ktemkin-archive/papilio-drv8833-wing/papilio_drv8833_wing.pdf

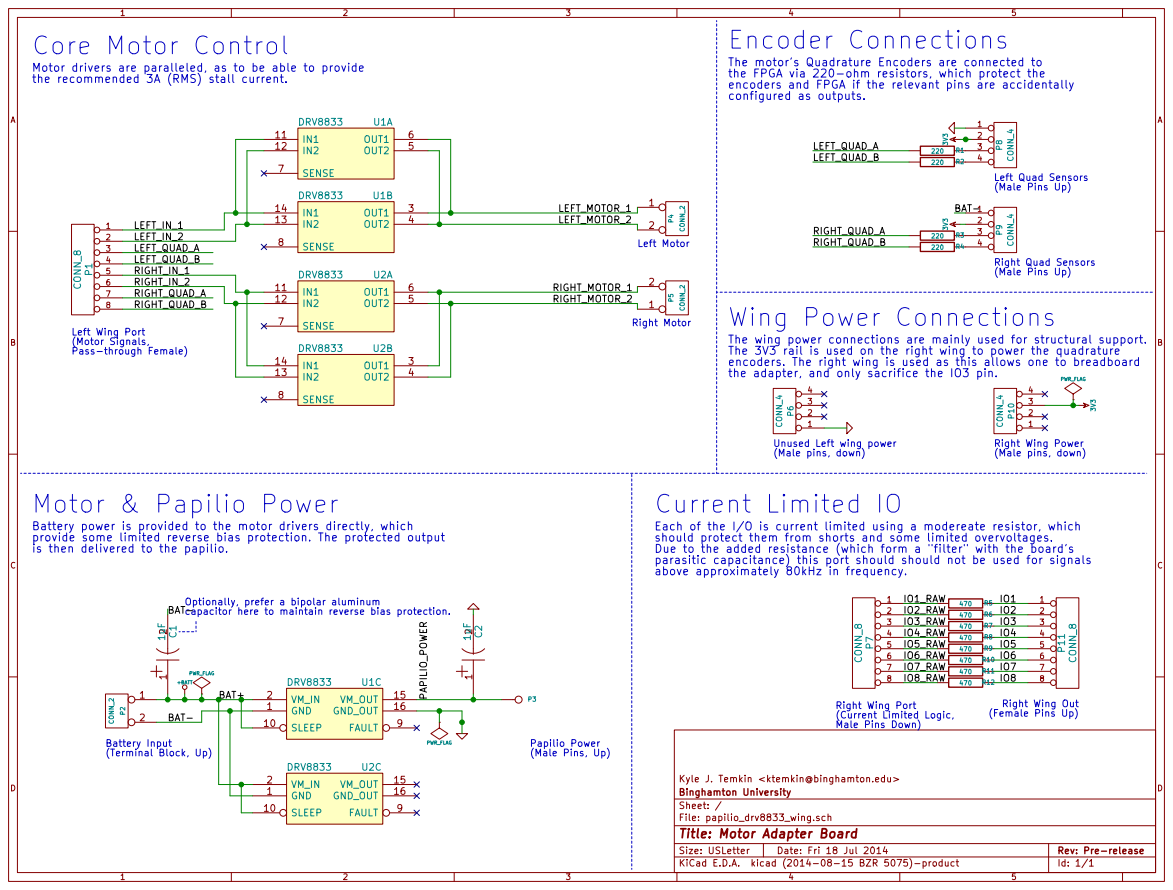
[picture p1: page 1]

The motor's Quadrature Encoders are connected to
the FPGA via 220-ohm resistors, which protect the
encoders and FPGA if the relevant pins are accidentally
configured as outputs.

Motor drivers are paralleled, as to be able to provide
the recommended 3A (RMS) stall current.

The wing power connections are mainly used for structural support.
The 3V3 rail is used on the right wing to power the quadrature
encoders. The right wing is used as this allows one to breadboard
the adapter, and only sacrifice the IO3 pin.

(Male pins, down) 1
Unused Left wing power

Battery power is provided to the motor drivers directly, which
provide some limited reverse bias protection. The protected output
is then delivered to the papilio.

Each of the I/O is current limited using a modereate resistor, which
should protect them from shorts and some limited overvoltages.
Due to the added resistance (which form a "filter" with the board's
parasitic capacitance) this port should should not be used for signals

Kyle J. Temkin <ktemkin@binghamton.edu>
File: papilio_drv8833_wing.sch Sheet: / Binghamton University

Id: 1/1 Title: Motor Adapter Board
