ktemkin-archive/papilio-drv8833-wing/papilio_drv8833_wing.kicad_pcb

## KiCad design papilio_drv8833_wing.kicad_pcb (2015-10-08)

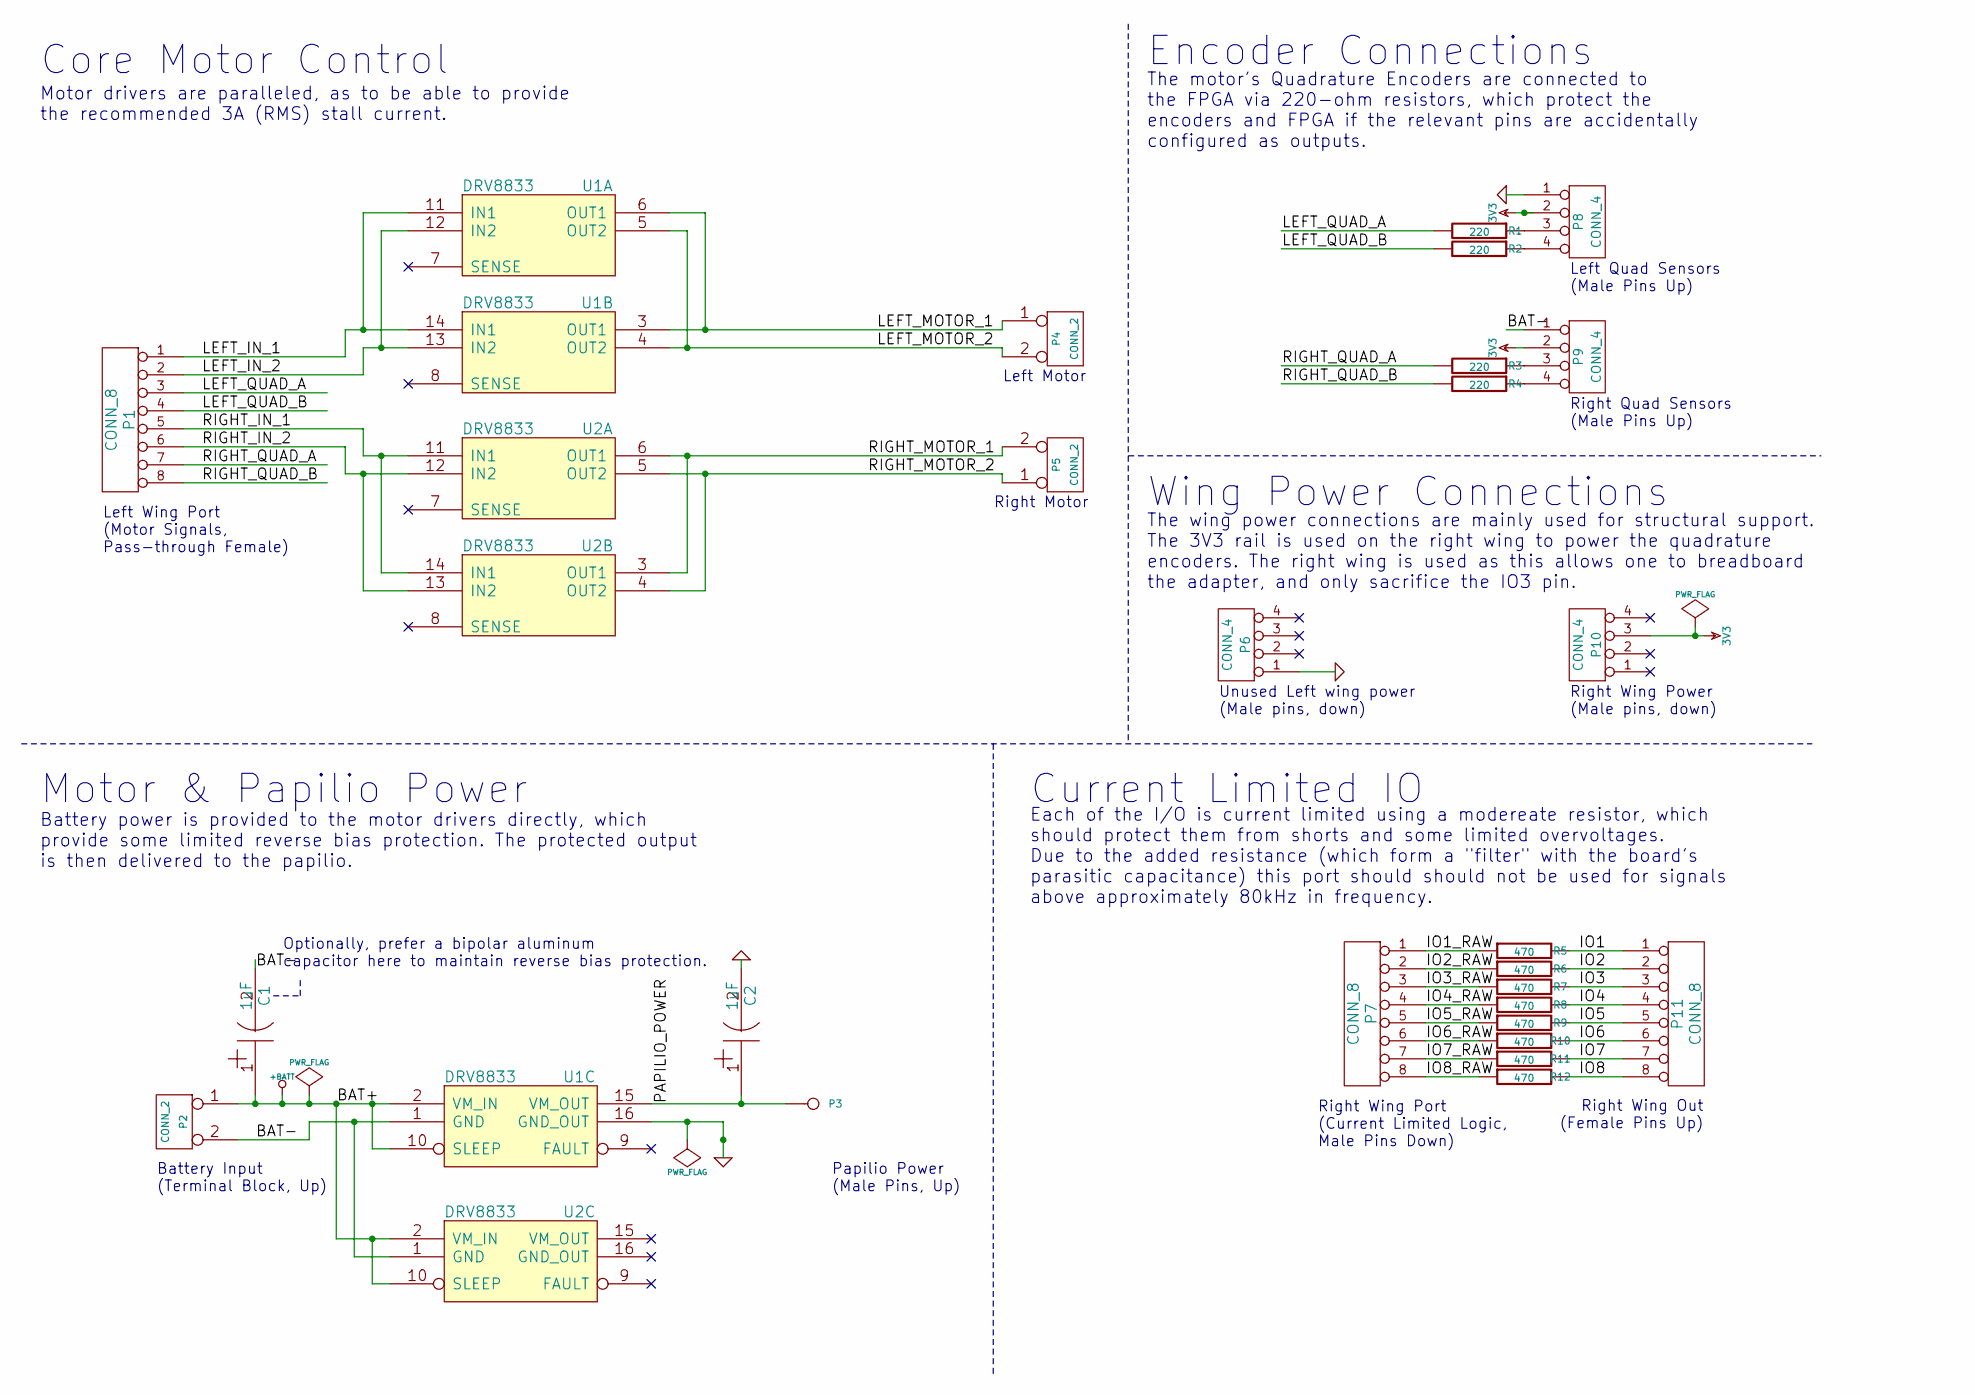
[picture p2: schematic papilio_drv8833_wing.sch, Motor Adapter Board]

Parts:
C1, C2: 1uF; Capacitor5x11RM2.5
P1, P7, P11: CONN_8; SIL-8
P2: CONN_2; terminal-block-D021B01LF
P3: CONN_1; SIL-1
P4, P5: CONN_2; rover5-motor
P6, P8, P9, P10: CONN_4; SIL-4
R1, R2, R3, R4: 220; Resistor_Horizontal_RM10mm
R5, R6, R7, R8, R9, R10, R11, R12: 470; Resistor_Horizontal_RM10mm
U1, U2: DRV8833; DRV8833-carrier

Connections:
3V3: P8.2, P9.2, P10.3
+BATT: C1.1, P2.1, U1.2 (VM_IN), U1.10 (SLEEP), U2.2 (VM_IN), U2.10 (SLEEP)
/BAT-: C1.2, P2.2 (PM), P9.1, U1.1 (GND), U2.1 (GND)
/IO1: P11.1, R5.2
/IO1_RAW: P7.1, R5.1
/IO2: P11.2, R6.2
/IO2_RAW: P7.2, R6.1
/IO3: P11.3, R7.2
/IO3_RAW: P7.3, R7.1
/IO4: P11.4, R8.2
/IO4_RAW: P7.4, R8.1
/IO5: P11.5, R9.2
/IO5_RAW: P7.5, R9.1
/IO6: P11.6, R10.2
/IO6_RAW: P7.6, R10.1
/IO7: P11.7, R11.2
/IO7_RAW: P7.7, R11.1
/IO8: P11.8, R12.2
/IO8_RAW: P7.8, R12.1
/LEFT_IN_1: P1.1, U1.11 (IN1), U1.14 (IN1)
/LEFT_IN_2: P1.2, U1.12 (IN2), U1.13 (IN2)
/LEFT_MOTOR_1: P4.1, U1.3 (OUT1), U1.6 (OUT1)
/LEFT_MOTOR_2: P4.2 (PM), U1.4 (OUT2), U1.5 (OUT2)
/LEFT_QUAD_A: P1.3, R1.2
/LEFT_QUAD_B: P1.4, R2.2
/PAPILIO_POWER: C2.1, P3.1, U1.15 (VM_OUT)
/RIGHT_IN_1: P1.5, U2.11 (IN1), U2.14 (IN1)
/RIGHT_IN_2: P1.6, U2.12 (IN2), U2.13 (IN2)
/RIGHT_MOTOR_1: P5.2 (PM), U2.3 (OUT1), U2.6 (OUT1)
/RIGHT_MOTOR_2: P5.1, U2.4 (OUT2), U2.5 (OUT2)
/RIGHT_QUAD_A: P1.7, R3.2
/RIGHT_QUAD_B: P1.8, R4.2
GND: C2.2, P6.1, P8.1, U1.16 (GND_OUT)
unnamed: P8.3, R1.1
unnamed: P8.4, R2.1
unnamed: P9.3, R3.1
unnamed: P9.4, R4.1

Notes on the sheet:
Right Wing Power (Male pins, down)
Left Wing Port (Motor Signals, Pass-through Female)
Left Quad Sensors (Male Pins Up)
Left Motor
Right Motor
Right Wing Port (Current Limited Logic, Male Pins Down)
Right Wing Out (Female Pins Up)
Right Quad Sensors (Male Pins Up)
Battery Input (Terminal Block, Up)
Papilio Power (Male Pins, Up)
Unused Left wing power (Male pins, down)
Core Motor Control
Motor drivers are paralleled, as to be able to provide the recommended 3A (RMS) stall current.
Motor & Papilio Power
Battery power is provided to the motor drivers directly, which provide some limited reverse bias protection. The protected output is then delivered to the papilio.
Encoder Connections
The motor's Quadrature Encoders are connected to the FPGA via 220-ohm resistors, which protect the encoders and FPGA if the relevant pins are accidentally configured as outputs.
Wing Power Connections
The wing power connections are mainly used for structural support. The 3V3 rail is used on the right wing to power the quadrature encoders. The right wing is used as this allows one to breadboard the adapter, and only sacrifice the IO3 pin.
Current Limited IO
Each of the I/O is current limited using a modereate resistor, which should protect them from shorts and some limited overvoltages. Due to the added resistance (which form a "filter" with the board's parasitic capacitance) this port should should not be used for signals above approximately 80kHz in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
Optionally, prefer a bipolar aluminum capacitor here to maintain reverse bias protection.

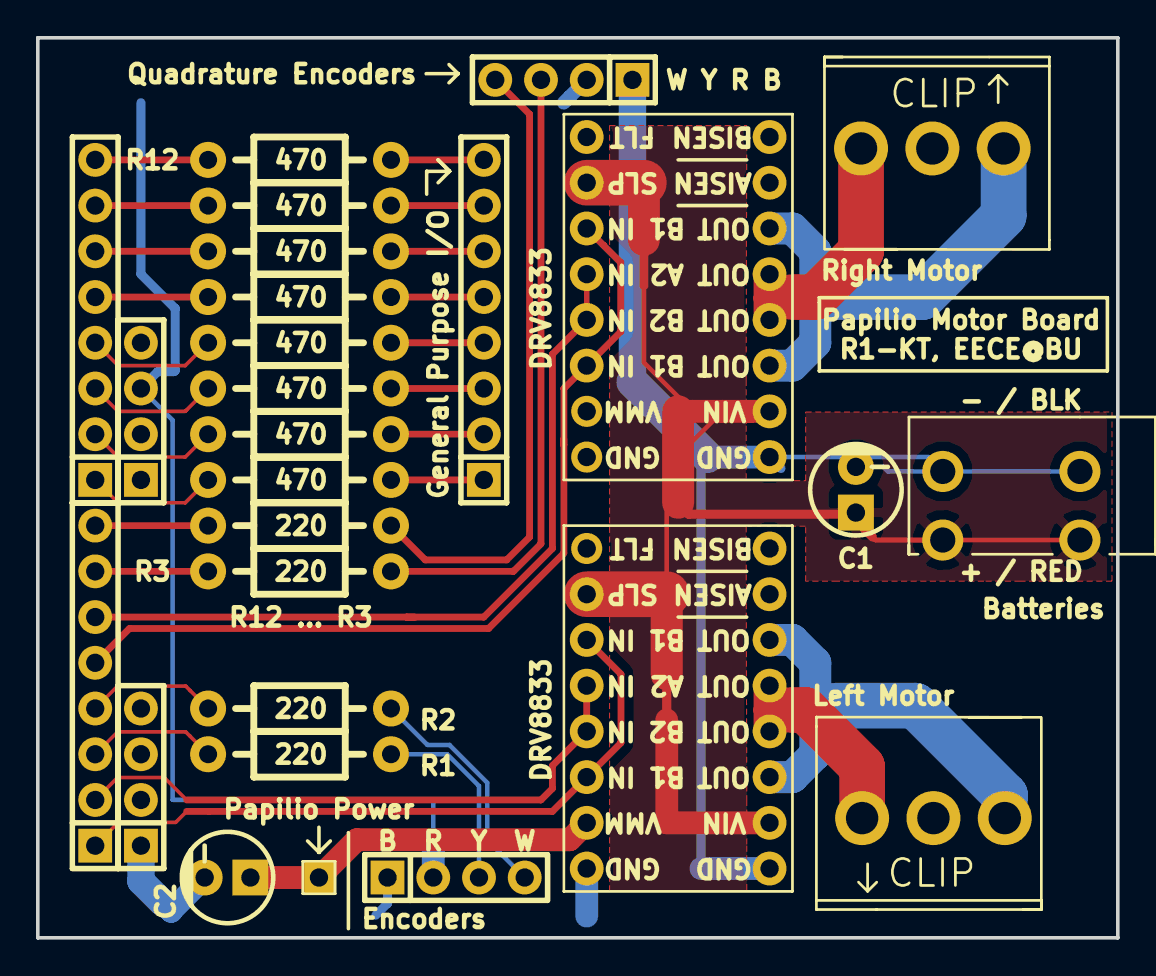
[picture p3: board papilio_drv8833_wing.kicad_pcb from above]

Board: 2 copper layers, 60.0 x 50.0 mm, 27 parts (0 on the bottom side), 37 nets.
