ktemkin-archive/papilio-drv8833-wing/TestVHDL/SwitchLED/toplevel_summary.html

toplevel Project Status (08/28/2014 - 21:10:19)
Project File: | SwitchLED.xise | Parser Errors: | No Errors
Module Name: | toplevel | Implementation State: | Synthesized (Failed)
Target Device: | xc3s250e-5cp132 | Errors: | X 1 Error (1 new)
Product Version: | ISE 14.7 | Warnings: | No Warnings
Design Goal: | Balanced | Routing Results:
Design Strategy: | Xilinx Default (unlocked) | Timing Constraints:
Environment: | System Settings | Final Timing Score:

Detailed Reports | | | | | | [-]
Report Name | Status | Generated | Errors | Warnings | Infos
Synthesis Report | Current | Thu Aug 28 21:10:19 2014 | X 1 Error (1 new) | 0 | 0
Translation Report
Map Report
Place and Route Report
Power Report
Post-PAR Static Timing Report
Bitgen Report

Secondary Reports | | | [-]
Report Name | Status | Generated

Date Generated: 08/28/2014 - 21:10:19
