ktemkin-archive/papilio-drv8833-wing/TestVHDL/SwitchLED/toplevel_envsettings.html

System Settings

Environment Settings
Environment Variable | xst | ngdbuild | map | par
LD_LIBRARY_PATH | /opt/Xilinx/14.7/ISE_DS/ISE//lib/lin64: /usr/heimdal/lib | < data not available > | < data not available > | < data not available >
PATH | /opt/Xilinx/14.7/ISE_DS/ISE//bin/lin64: /usr/local/bin: /usr/local/sbin: /usr/bin: /usr/sbin: /bin: /sbin: /home/ktemkin/bin: /usr/bin/X11: /usr/games: /home/ktemkin/.local/bin: /opt/android-sdk-linux_86/tools: /home/ktemkin/.bin: /opt/Xilinx/14.7/ISE_DS/ISE/bin/lin64: /home/ktemkin/cxoffice/bin: /home/ktemkin/.gem/ruby/1.9.1/bin: /opt/altera/13.0sp1/quartus/bin | < data not available > | < data not available > | < data not available >
XILINX | /opt/Xilinx/14.7/ISE_DS/ISE/ | < data not available > | < data not available > | < data not available >
XILINXD_LICENSE_FILE | 2100@owls.bgm.bu.int | < data not available > | < data not available > | < data not available >

Synthesis Property Settings
Switch Name | Property Name | Value | Default Value
-ifn | | toplevel.prj
-ifmt | | mixed | MIXED
-ofn | | toplevel
-ofmt | | NGC | NGC
-p | | xc3s250e-5-cp132
-top | | toplevel
-opt_mode | Optimization Goal | Speed | SPEED
-opt_level | Optimization Effort | 1 | 1
-iuc | Use synthesis Constraints File | NO | NO
-keep_hierarchy | Keep Hierarchy | No | NO
-netlist_hierarchy | Netlist Hierarchy | As_Optimized | as_optimized
-rtlview | Generate RTL Schematic | Yes | NO
-glob_opt | Global Optimization Goal | AllClockNets | ALLCLOCKNETS
-read_cores | Read Cores | YES | YES
-write_timing_constraints | Write Timing Constraints | NO | NO
-cross_clock_analysis | Cross Clock Analysis | NO | NO
-bus_delimiter | Bus Delimiter | <> | <>
-slice_utilization_ratio | Slice Utilization Ratio | 100 | 100%
-bram_utilization_ratio | BRAM Utilization Ratio | 100 | 100%
-verilog2001 | Verilog 2001 | YES | YES
-fsm_extract | | YES | YES
-fsm_encoding | | Auto | AUTO
-safe_implementation | | No | NO
-fsm_style | | LUT | LUT
-ram_extract | | Yes | YES
-ram_style | | Auto | AUTO
-rom_extract | | Yes | YES
-shreg_extract | | YES | YES
-rom_style | | Auto | AUTO
-auto_bram_packing | | NO | NO
-resource_sharing | | YES | YES
-async_to_sync | | NO | NO
-mult_style | | Auto | AUTO
-iobuf | | YES | YES
-max_fanout | | 500 | 500
-bufg | | 24 | 24
-register_duplication | | YES | YES
-register_balancing | | No | NO
-optimize_primitives | | NO | NO
-use_clock_enable | | Yes | YES
-use_sync_set | | Yes | YES
-use_sync_reset | | Yes | YES
-iob | | Auto | AUTO
-equivalent_register_removal | | YES | YES
-slice_utilization_ratio_maxmargin | | 5 | 0%

Operating System Information
Operating System Information | xst | ngdbuild | map | par
CPU Architecture/Speed | AMD FX(tm)-8350 Eight-Core Processor/1400.000 MHz | < data not available > | < data not available > | < data not available >
Host | arch | < data not available > | < data not available > | < data not available >
OS Name | unknown | < data not available > | < data not available > | < data not available >
OS Release | unknown | < data not available > | < data not available > | < data not available >
